Lv-L/PistonLiquidRocket/Documentation Vault/99-Attachments/Nozzle.png

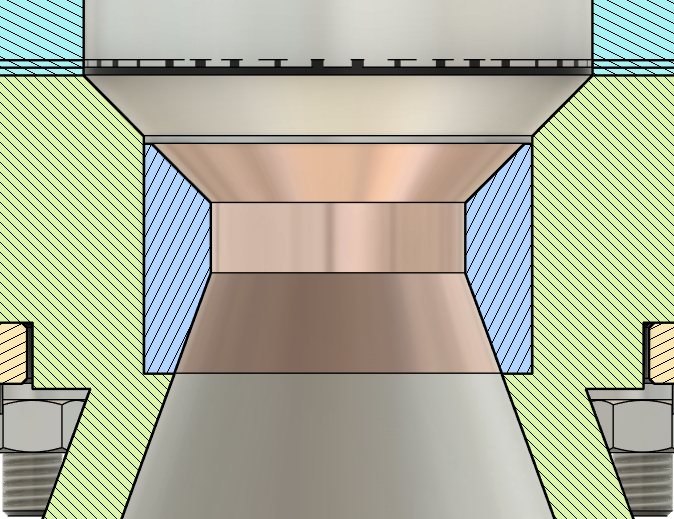
Documentation Vault/99-Attachments/Nozzle.png
