Lv-L/PistonLiquidRocket/Documentation Vault/00-Project/Decisions Log.md

| Date | Decision | Rationale | Alternatives Considered |
| --- | --- | --- | --- |
| 7/06/2026 | IPA fuel type | Higher impulse for same tank volume as ethanol at ~2500 K flame temperature. Hydrocarbons ruled out for ease of reuse (cleanliness) | Ethanol, hydrocarbon fuels |
