Lv-L/PistonLiquidRocket/Documentation Vault/02-Design/01-Propulsion System/01-Propulsion System Overview.md

# Propulsion System Overview

## Propellant Selection
<!-- Oxidizer / fuel choices, reasoning -->

## Performance Targets
| Parameter | Value |
| --- | --- |
| Total impulse | ~5000 Ns, <5120 Ns |
| Liftoff TWR | 5 (minimum) |
| Pressure rating | 1000 psi |
Total impulse: 5000 Ns at lowest (highest impulse) ambient temperature to stay under L2 limit of 5120 Ns [(L motor)](https://en.wikipedia.org/wiki/Model_rocket_motor_classification)
TWR: "at least" 5, from [Tripoli](https://www.tripoli.org/safetycode) - **880 N minimum initial thrust** at an initial mass estimate of 18 kg (from Half Cat, full propellant load)
Pressure rating: 1000 psi for saturation pressure of N2O at 35 deg C
## Fluid System Architecture
Pressure fed by nitrous oxide, as required by [Tripoli](https://tripoli.org/content.aspx?page_id=5&club_id=795696&item_id=126571&)

P&ID Diagram:
![[P&ID.png]]

## Engine Architecture
### Oxidiser
Nitrous oxide (N<sub>2</sub>O) is used as the oxidiser due to its explicit requirement by Tripoli. It self-pressurises at room temperature and has limited chemical incompatibilities (unlike liquid oxygen), and is relatively non-toxic (compared to hydrogen peroxide).
### Fuel
A comparison of potential fuel types is summarised below:

| Fuel Type | Safety | Cost | Availability | Max Isp (s) | Flame | Notes |
| --- | --- | --- | --- | --- | --- | --- |
| Isopropyl alcohol (IPA) | Good | [$4.5/L](https://www.sydneysolvents.com.au/isopropyl-alcohol-100-20-litre) | Delivery | 257 s | Faint orange | Easy to obtain pure |
| Ethanol | Good | [$4.0/L](https://www.sydneysolvents.com.au/industrial-methylated-spirits-20-litre) | Delivery | 260 s | Almost invisible blue/yellow | Sometimes low purity |
| Diesel | Good | [$2.1/L](https://petrolspy.com.au/map/latlng/-27.530393745221538/153.04868461871592) | Any petrol station | 251 s | Bright orange | Leaves oily film |
| E85 | Moderate | [$2.3/L](https://petrolspy.com.au/map/latlng/-27.544466300664432/153.06961875315346) | United petrol station | 258 s | Moderate orange/light blue | More flammable than ethanol |
| Acetone | Moderate | [$4.8/L](https://www.sydneysolvents.com.au/acetone-20-litre) | Delivery | 253 s | Moderate orange/blue | Tends to swell O-rings |
| Methanol | Poor | [$2.5/L](https://www.sydneysolvents.com.au/methanol-20-litre) | Delivery | ~ | Almost invisible light blue  | "Should not be used" - Half Cat |
On the basis of safety, the use of methanol was ruled out due to its high toxicity.

For propellants, ethanol was chosen for its high performance and availability, with E85 as a secondary option for a more visible flame at the slight cost of performance. Running the engine with ethanol will require less maintenance as it doesn't leave a residue, unlike E85.

![[tc_isp_vs_lambda.png]]

An OF of 2 will be used initially to reduce flame temperature with a small penalty in Isp. For ethanol, an OF ratio of 2 results in an adiabatic flame temperature of 2828 K and an Isp of 252 s. This means a penalty of 8 s of Isp gives a temperature reduction of 489 K (with ethanol's peak Isp being 260 s at an adiabatic flame temperature of 3317 K).

### Nozzle
The nozzle throat diameter and expansion ratio were copied taken Half Cat:

| Variable | Value |
| --- | ----- |
| Throat diameter (mm) | 25 |
| Expansion Ratio | 4 |

### Combustion Chamber
Chamber dimensions were copied from Half Cat, given that chamber sizing is typically done from past experience.

| **Dimension name** | Dimension (mm) |
| --- | --- |
| Chamber ID | 51 |
| Chamber length | 127 |
| Characteristic length (L*) | 635 |
### Components
#### Tanks
The tank is a "piston style" tank that is the same as Half Cat's design, where the vapor pressure of the N2O pushes along a piston to expel the fuel. From the Half Cat Mojave Sphinx Guidebook:
![[MS Propellant Tank.png]]
#### Regulators
No regulators are used - instead the main valves are set to open at a point between the operating pressure and the burst pressure of the tank, in the case of an extremely hot day or radiative heating of the tank resulting in it being heated to greater than 35 degrees C.
#### Valves
1/4" (8mm) BSP, 304 Stainless Steel, 2 Pc Ball Valve, Full Port, 1000 PSI - [Camlock Fittings]([https://www.aircraftspruce.com.au/catalog/appages/highpressurevalve.php](https://www.camlockfittings.com.au/1-4-ball-valve-ss304.html))
Use 3d print with [DS3225 servo - Amazon](https://www.amazon.com.au/AKLOSIPY-DS3225MG-Digital-Servo-Multiple/dp/B0FX16CGW4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) to convert to servo valve for ox fill valve, main ox valve and main fuel valve.
#### Plumbing (Hose + Fittings)
See [03-Fluid System](03-Fluid%20System.md)
## Analysis
The simulation models a piston-fed N2O + liquid fuel rocket where a two-phase N2O tank self-pressurises and drives a piston to expel fuel. At each timestep it computes propellant mass flow rates through injector orifices (using incompressible orifice flow), calls rocketCEA to get ideal combustion properties (T0, γ, MW, c*), applies combustion efficiency to get actual c*, then solves the chamber pressure from c* = Pc·At/ṁ. Thrust and Isp follow from the nozzle expansion, and the N2O tank state evolves via an adiabatic energy balance accounting for liquid/vapour phase change.

For the purposes of initial analysis, a target injector pressure drop was set at 20% initial feed pressure. A combustion efficiency of 65% and a nozzle efficiency of 97% was used. Half Cat's feed line geometries were used to estimate feed line pressure drop, this can be fine tuned as the design progresses to CAD.

Inputs (non exhaustive):
- Tank volume (ox + fuel): 5L
- Ox tank diameter: 101.6 mm
- Ox ullage: 5% by volume
- Fuel: Ethanol
- O/F: 2.0
- Throat diameter: 25.4 mm
- Nozzle expansion ratio: 4

Hot day (30C):
![[engine_simulation_30C.png]]
Results:
- Burn time: 2.7 s
- Avg/peak thrust: 1473.0 N / 1735.5 N
- Avg Isp: 141.9 s
- Total impulse: 4006.5 Ns

Cold day (10C):
![[engine_simulation_10C.png]]
Results:
- Burn time: 4.29 s
- Avg/peak thrust: 1143.9 N / 1351.7 N
- Avg Isp: 137.6 s
- Total impulse: 4894.2 Ns
## Related
- [[02-Design/03-Ground Support Equipment/GSE Overview]]
- [[02-Design/04-Flight Systems/Flight Systems Overview]]
