Lv-L/PistonLiquidRocket/Documentation Vault/02-Design/01-Propulsion System/03-Fluid System.md

# Oxidiser
# QD - Ox Tank
| Fitting | Input | Output | Material | Cost | Supplier |
| --- | --- | --- | --- | ---- | --- |
| QD fitting (female) | - | 1/8" BSPT female | | | |
| Air line elbow | 1/8" BSPT male | 1/4" OD tube compression (Uni-Lok) | Brass | | [IFS B-04UME-02R](https://www.ifsqld.com.au/libraries/resources/pdfs/IFS%202025%20UN-PRICED%20MASTER%20PT2.pdf) |

# Ox Tank - Combustion Chamber
| Fitting | Input | Output | Material | Cost | Supplier |
| --- | --- | --- | --- | --- | --- |
| Bulkhead | - | 1/4" BSPT female | Aluminium | - | - |
| Nipple | 1/4" BSPT male | 1/4" BSPT male | Brass | | [IFS 2812](https://www.ifsqld.com.au/libraries/resources/pdfs/IFS%202025%20UN-PRICED%20MASTER%20PT1.pdf)  |
| Main valve | 1/4" BSPP female | 1/4" BSPP female | 304 stainless steel | A$6.29 | [Camlock Fittings](https://www.camlockfittings.com.au/1-4-ball-valve-ss304.html) |
| Flare fitting | 1/4" BSPT male | AN6 male | Aluminium | A$3.99 | [EFI Solutions](https://www.efisolutions.com.au/bspt-1-4-to-male-an6) |
| 180° hose end | AN6 female | AN6 hose | Aluminium | A$18.39 | [EFI Solutions](https://www.efisolutions.com.au/180-degree-full-flow-ptfe-teflon-hose-end-an6) |
| Line (7/16" OD) | AN6 hose | AN6 hose | PTFE, braided stainless | A$18.99/m | [EFI Solutions](https://www.efisolutions.com.au/200-series-ptfe-teflon-braided-stainless-steel-hos~50095) |
| Hose end | AN6 hose | AN6 female | Aluminium | A$8.99 | [EFI Solutions](https://www.efisolutions.com.au/straight-full-flow-ptfe-teflon-hose-end-an6-black) |
| Flare fitting | AN6 male | 1/4" BSPT male | Aluminium | A$3.99 | [EFI Solutions](https://www.efisolutions.com.au/bspt-1-4-to-male-an6) |
| Injector | 1/4" BSPT female | - | Aluminium | - | - |

# Fuel

## Fuel Tank - Combustion Chamber
| Fitting | Input | Output | Material | Cost | Supplier |
| --- | --- | --- | --- | --- | --- |
| Bulkhead | - | 1/4" BSPT female | Aluminium | - | - |
| Nipple | 1/4" BSPT male | 1/4" BSPT male | Brass | | [IFS 2812](https://www.ifsqld.com.au/libraries/resources/pdfs/IFS%202025%20UN-PRICED%20MASTER%20PT1.pdf)  |
| Main valve | 1/4" BSPP female | 1/4" BSPP female | 304 stainless steel | A$6.29 | [Camlock Fittings](https://www.camlockfittings.com.au/1-4-ball-valve-ss304.html) |
| Flare fitting | 1/4" BSPT male | AN6 male | Aluminium | A$3.99 | [EFI Solutions](https://www.efisolutions.com.au/bspt-1-4-to-male-an6) |
| Hose end | AN6 female | AN6 hose | Aluminium | A$8.99 | [EFI Solutions](https://www.efisolutions.com.au/straight-full-flow-ptfe-teflon-hose-end-an6-black) |
| Line (7/16" OD) | AN6 hose | AN6 hose | PTFE, braided stainless | A$18.99/m | [EFI Solutions](https://www.efisolutions.com.au/200-series-ptfe-teflon-braided-stainless-steel-hos~50095) |
| Hose end | AN6 hose | AN6 female | Aluminium | A$8.99 | [EFI Solutions](https://www.efisolutions.com.au/straight-full-flow-ptfe-teflon-hose-end-an6-black) |
| Flare fitting | AN6 male | 1/8" BSPT male | Aluminium | A$3.99 | [EFI Solutions](https://www.efisolutions.com.au/bspt-1-8-to-male-an6) |
| Injector | 1/8" BSPT female | - | Aluminium | - | - |
