Lv-L/PistonLiquidRocket/Documentation Vault/02-Design/03-Flight Systems/01-Flight Systems Overview.md

# Flight Systems Overview

## Airframe
The airframe tubes and nosecone are made of fibreglass. For the tubes, an inner diameter of 101.6 mm is used, allowing for 4 inch aluminium tube stock to be used as a mandrel.

## Structures
<!-- Engine mount, tank mounts, load paths -->

## Recovery
<!-- Dual deploy system, ejection charges, parachutes -->

## Avionics
<!-- Flight computer, altimeter, wiring -->

## Analysis
<!-- Mass budget, CG/CP, stability margin -->

## Related
- [[01-Propulsion System Overview]]
- [[01-Requirements/Requirements]]
