Lv-L/PistonLiquidRocket/Documentation Vault/02-Design/03-Flight Systems/02-Fins.md

The fins are made of four 1/4" thick plywood pieces cut into a swept profile, ending just after the nozzle. They are mounted to four 25x25x3 mm aluminium brackets, which also serve to connect the thrust chamber to the propellant tank.
