Lv-L/PistonLiquidRocket/Documentation Vault/02-Design/02-Ground Support Equipment/01-GSE Overview.md

# Ground Support Equipment Overview

## Fill & Drain System
<!-- Propellant loading, venting, drain procedures -->

## Pressurization Panel
<!-- Regulators, gauges, fill lines -->

## Ignition System
<!-- Igniter driver, arming logic, safing -->

## Test Stand
<!-- Thrust measurement, instrumentation, hold-down -->

## Related
- [[01-Propulsion System Overview]]
- [[03-Testing/Testing Index]]
