Lv-L/PistonLiquidRocket/Documentation Vault/05-Reference/Reference Index.md

# Reference Index

## Standards
- [Tripoli Bi-Propellant Liquid Motor Requirements](https://tripoli.org/content.aspx?page_id=5&club_id=795696&item_id=126571&)

## Datasheets

## Literature / Papers
