Lv-L/PistonLiquidRocket/Documentation Vault/00-Project/MOC.md

# Project Map of Content

## Folders
- [[01-Requirements]] — system requirements and constraints
- [[02-Design]] — propulsion system, propellant system, GSE, flight systems
- [[03-Testing]] — test plans, data, anomaly reports
- [[04-Procurement]] — suppliers, lead times, specs
- [[05-Reference]] — standards, datasheets, literature

## Key Documents
- [[01-Requirements/Requirements]] — top-level requirements
- [[00-Project/Timeline]] — project milestones
- [[01-Propulsion System Overview]]
- [[01-GSE Overview]]
- [[01-Flight Systems Overview]]
