Lv-L/PistonLiquidRocket/bolt_tearout.png

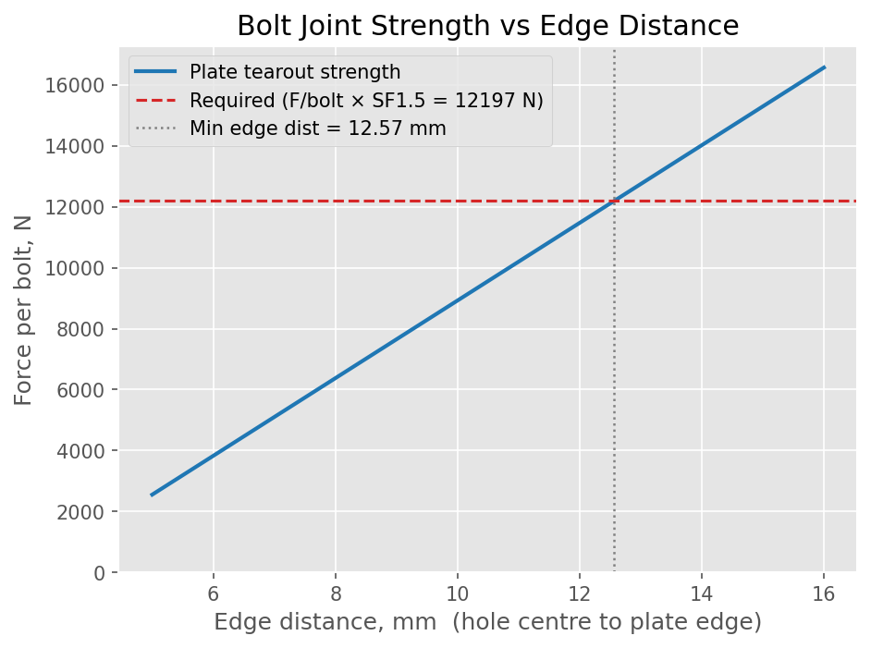
bolt_tearout.png
