Lv-L/PistonLiquidRocket/Documentation Vault/99-Attachments/bolt_tearout.png

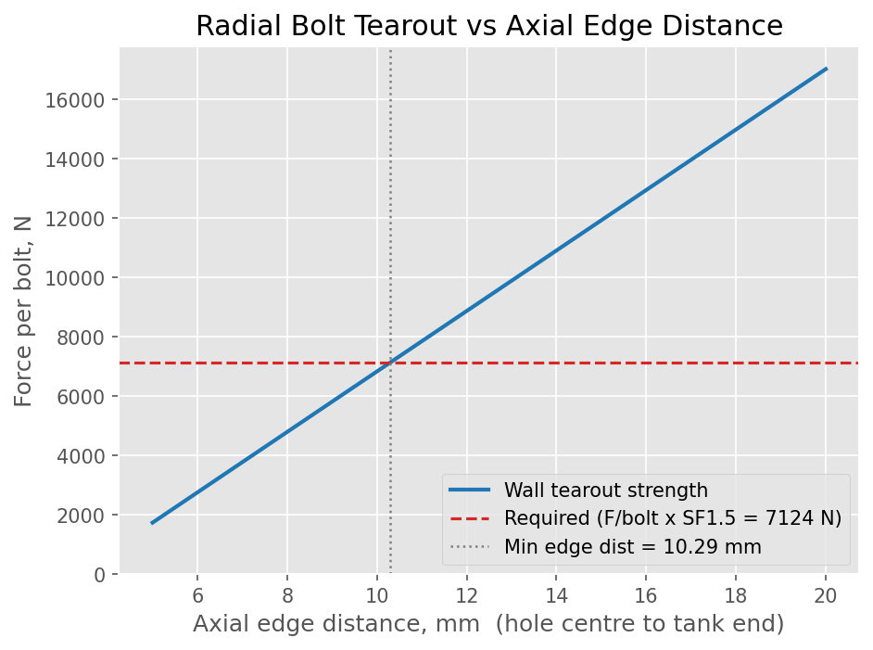
Documentation Vault/99-Attachments/bolt_tearout.png
