Lv-L/PistonLiquidRocket/Documentation Vault/99-Attachments/engine_simulation.png

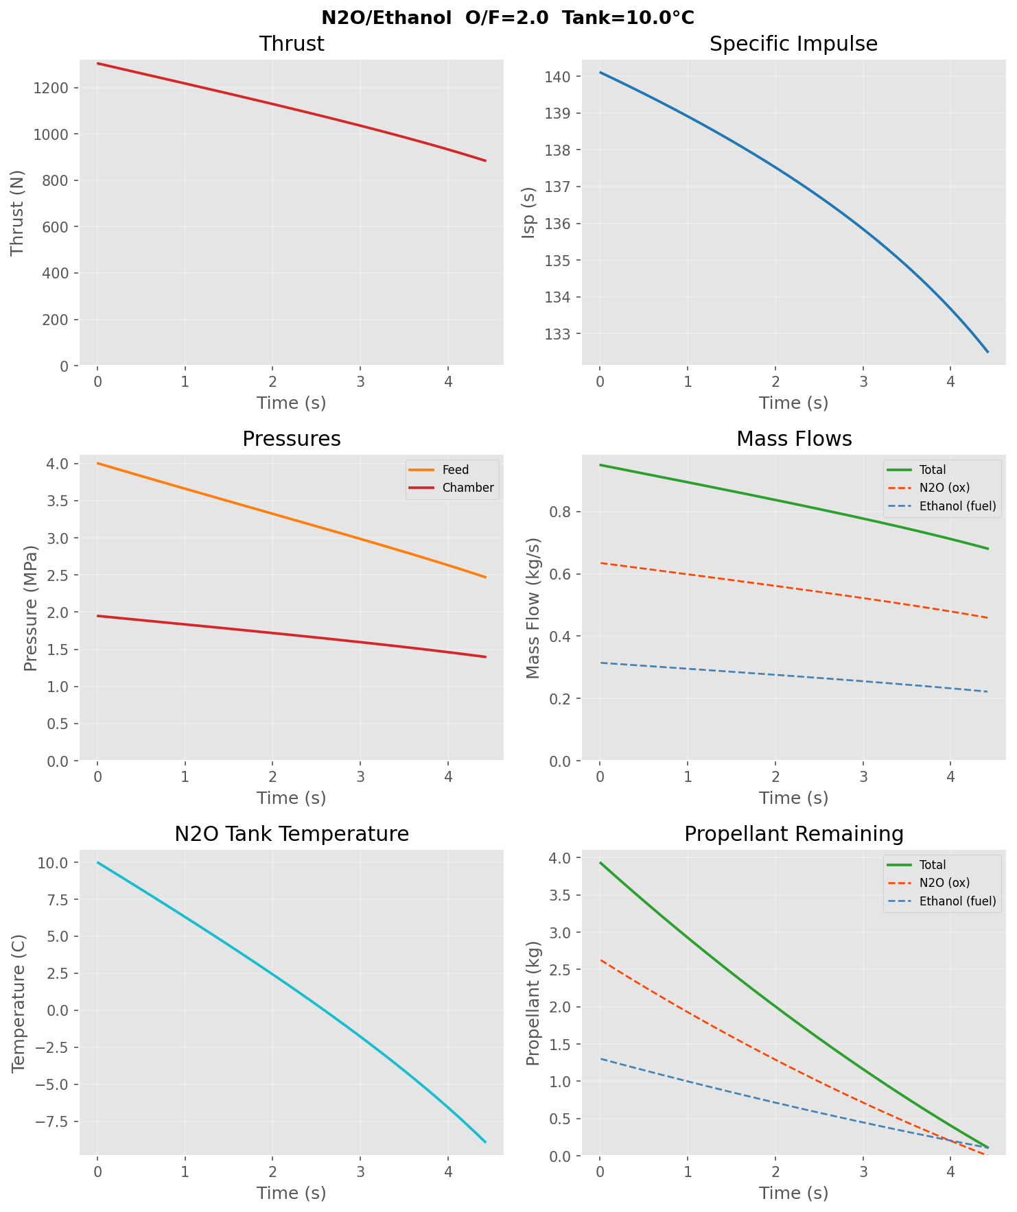
Documentation Vault/99-Attachments/engine_simulation.png
