Lv-L/PistonLiquidRocket/Documentation Vault/99-Attachments/O-ring Bulkhead.png

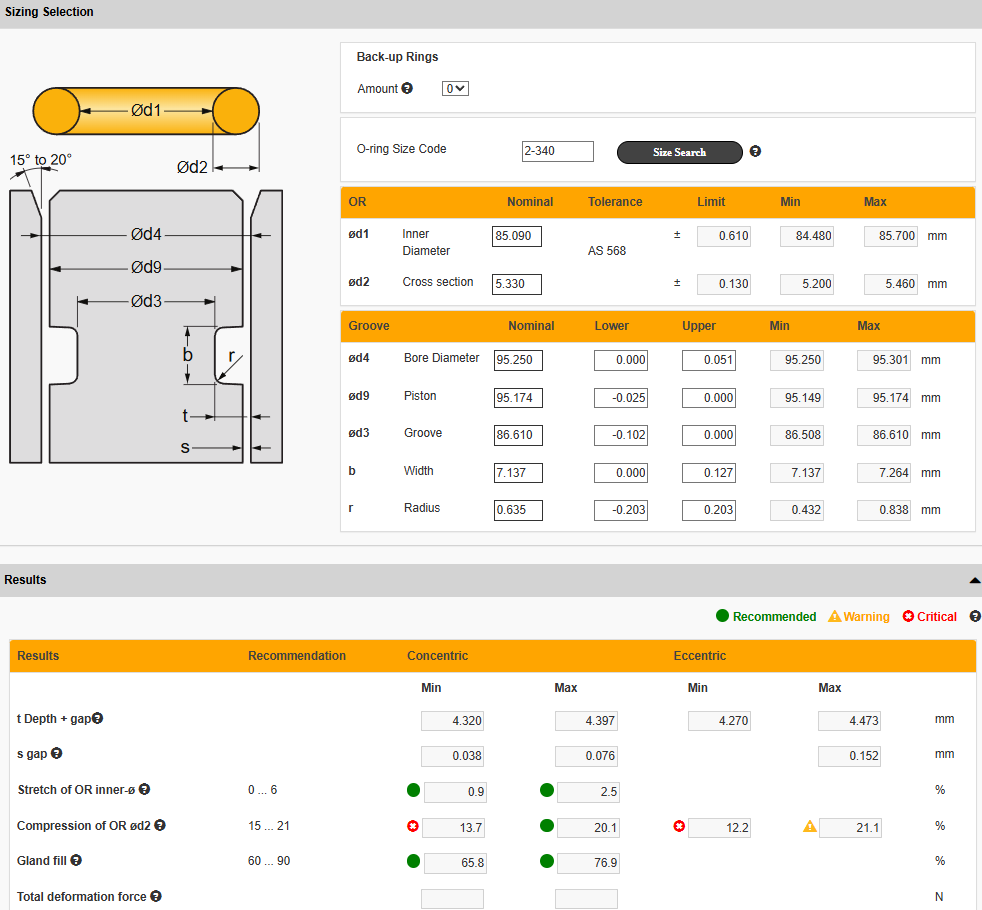
Documentation Vault/99-Attachments/O-ring Bulkhead.png
