Lv-L/PistonLiquidRocket/Documentation Vault/99-Attachments/O-ring Bulkheads.png

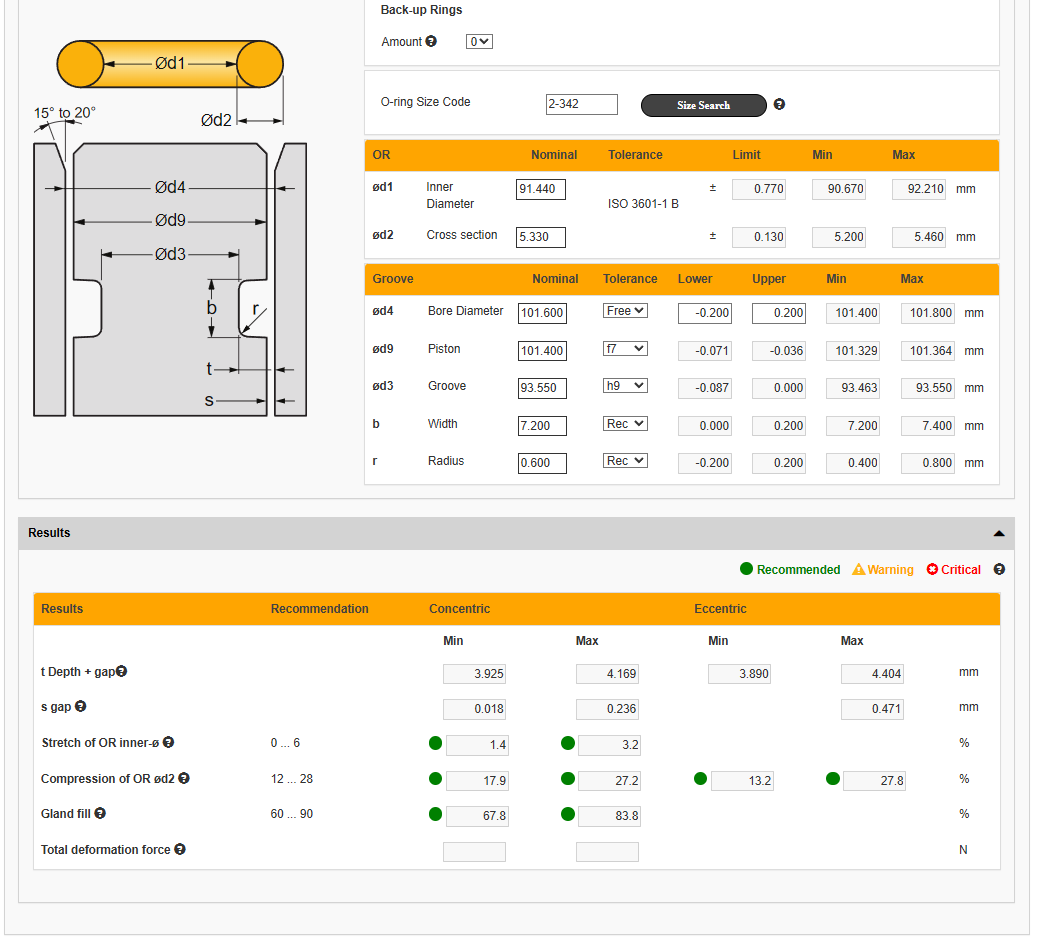
Documentation Vault/99-Attachments/O-ring Bulkheads.png
