Lv-L/PistonLiquidRocket/Documentation Vault/99-Attachments/O-ring Extrusion.png

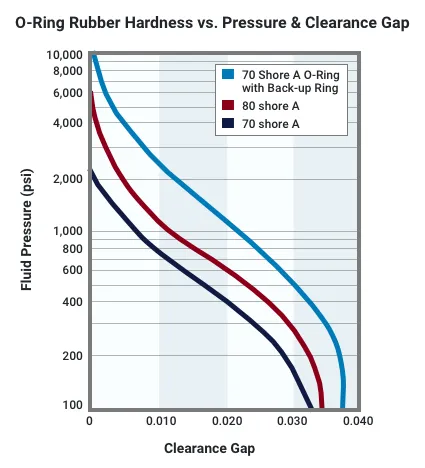
Documentation Vault/99-Attachments/O-ring Extrusion.png
