Lv-L/PistonLiquidRocket/Documentation Vault/99-Attachments/O-ring Injector.png

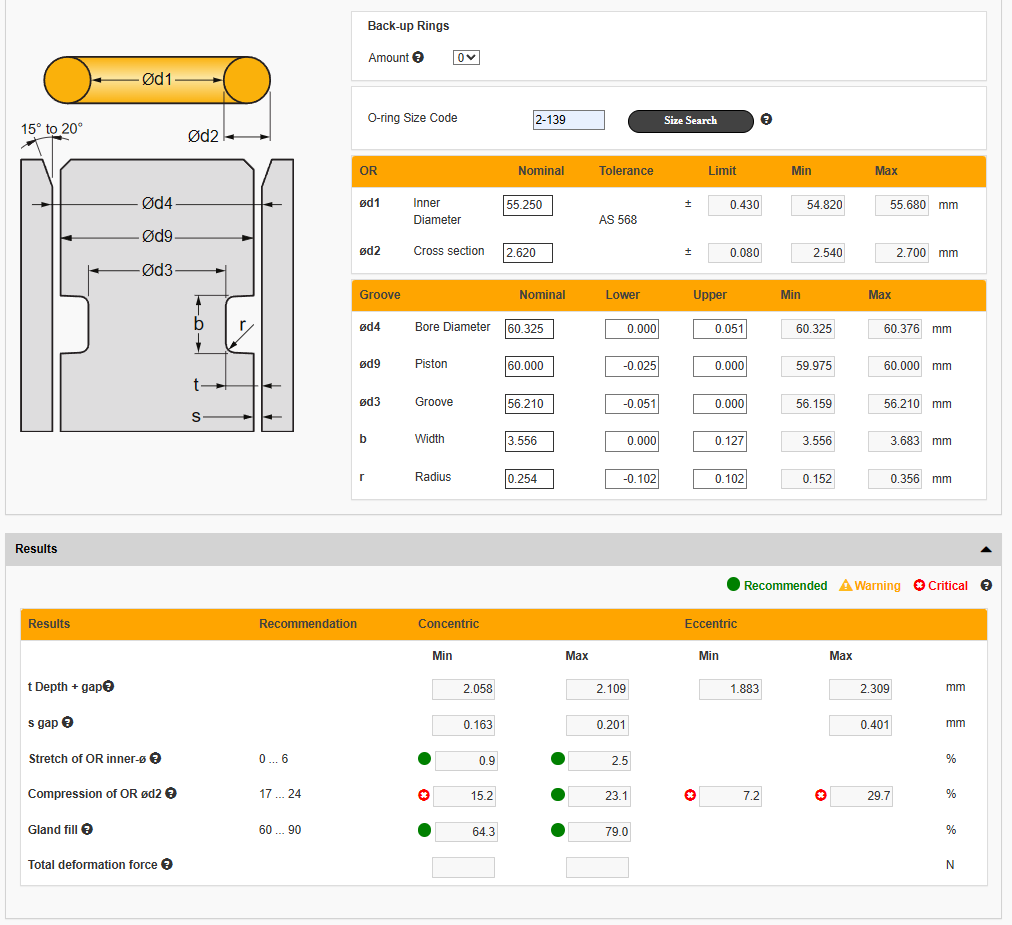
Documentation Vault/99-Attachments/O-ring Injector.png
