Lv-L/PistonLiquidRocket/Documentation Vault/99-Attachments/O-ring Piston.png

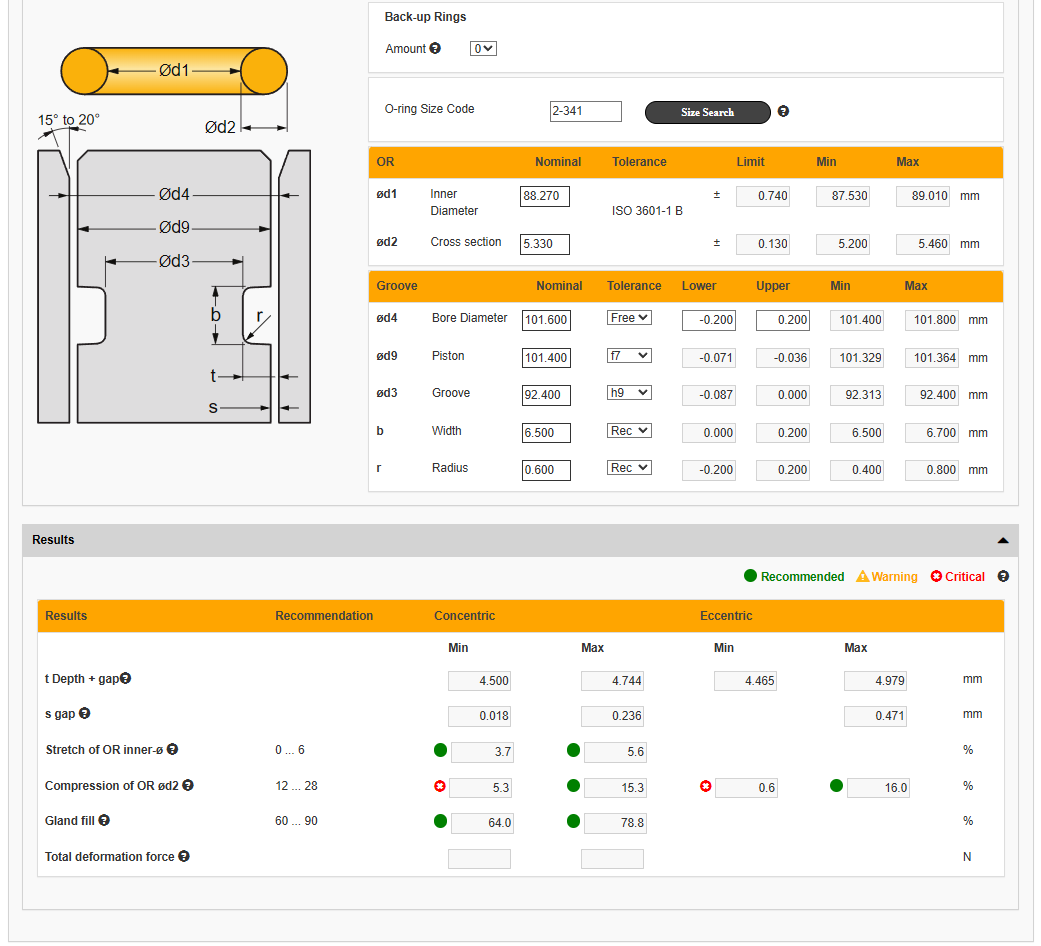
Documentation Vault/99-Attachments/O-ring Piston.png
