Lv-L/PistonLiquidRocket/Documentation Vault/99-Attachments/tc_isp_vs_lambda.png

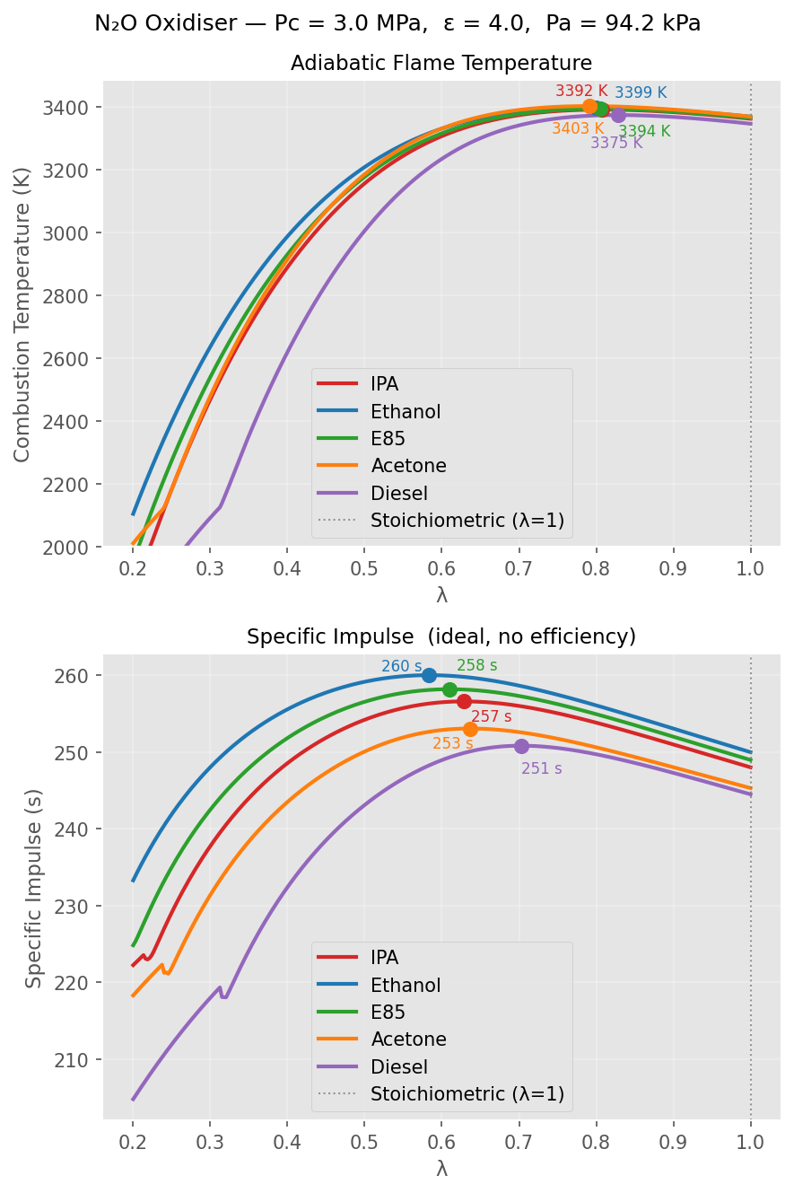
Documentation Vault/99-Attachments/tc_isp_vs_lambda.png
