Lv-L/PistonLiquidRocket/Documentation Vault/P&ID.png

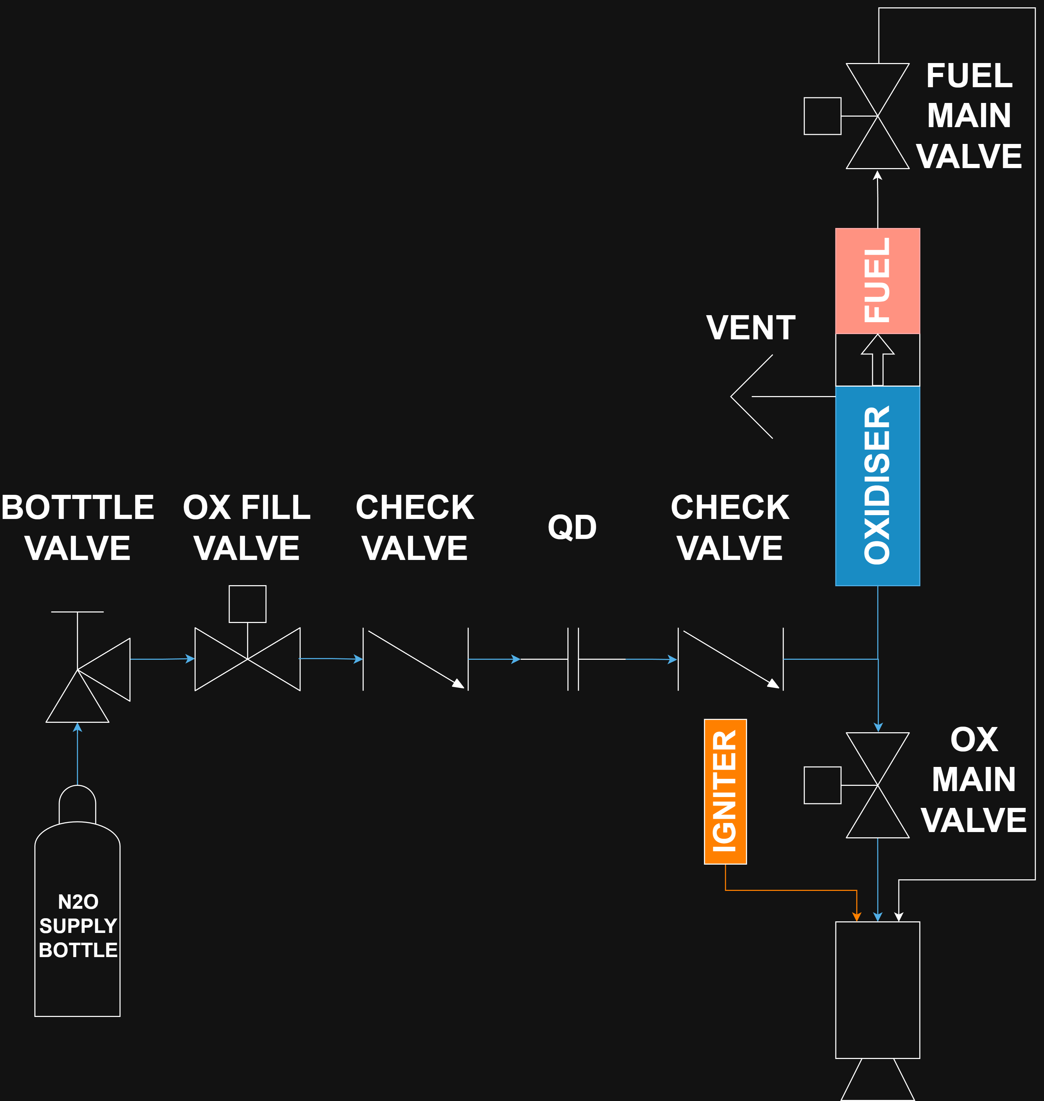
Documentation Vault/P&ID.png
