Lv-L/PistonLiquidRocket/Documentation Vault/Pasted image 20260610212356.png

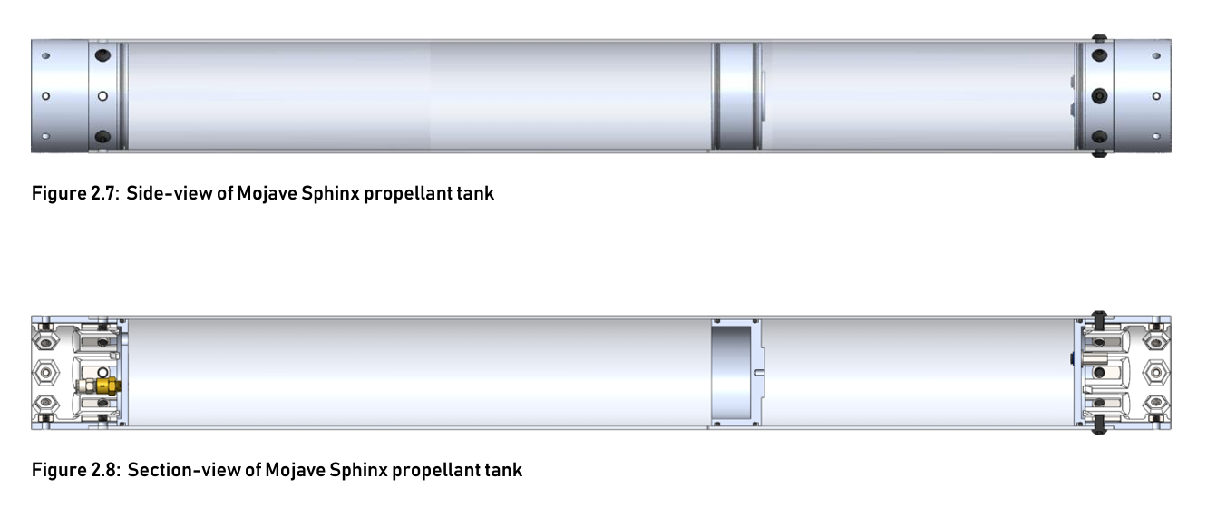
Documentation Vault/Pasted image 20260610212356.png
