Lv-L/PistonLiquidRocket/Hoop Stress.png

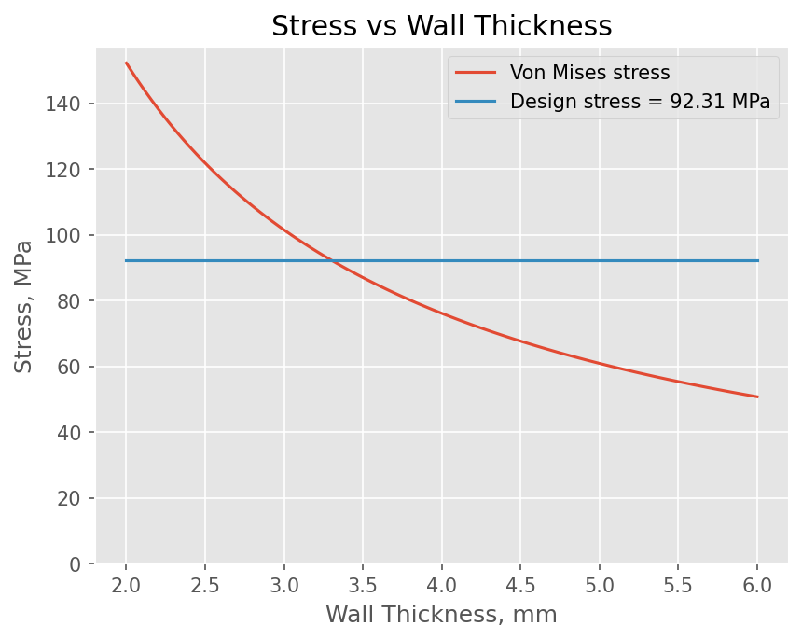
Hoop Stress.png
