Lv-L/PistonLiquidRocket/Simulation/lambda_vs_of.png

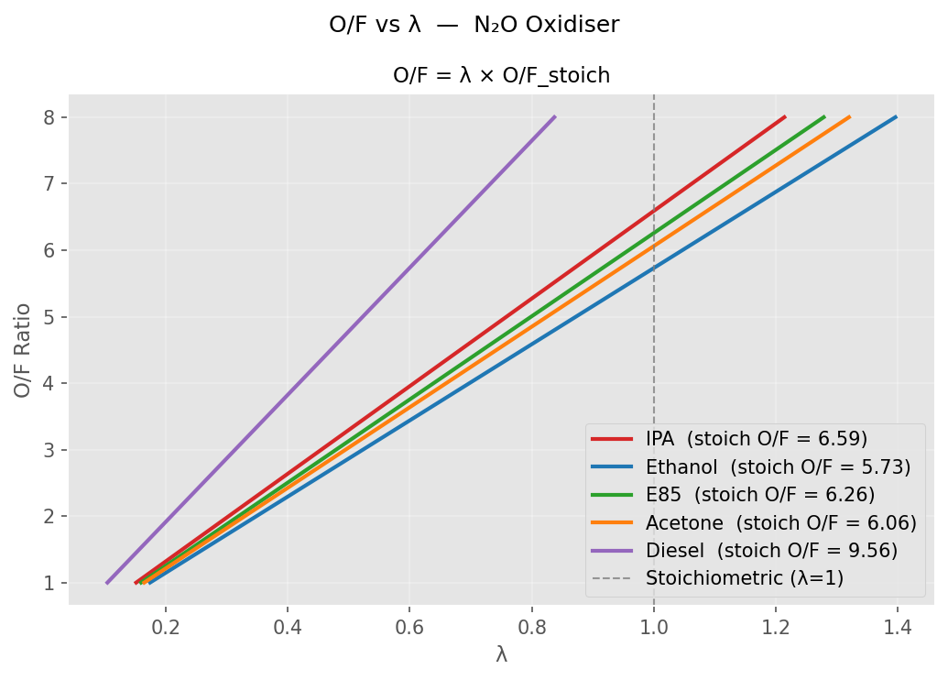
Simulation/lambda_vs_of.png
