Lv-L/PistonLiquidRocket/Finance/Purchases.xlsx

Description | Buyer | Cost | Date | Receipt name | Receipt
5x valves | Luke | $52.20 | 2026-11-01 | 20261101 - 5x valves.pdf | Open File
