Lv-L/PistonLiquidRocket/(list of files, cad)

Other CAD files:
CAD/DL_servo_mount.f3z
