Lv-L/PistonLiquidRocket/Documentation Vault/03-Testing/Testing Index.md

# Testing Index

## Test Plans
- Cold-flow test plan
- Hot-fire test plan

## Test Data

## Anomaly Reports
