Lv-L/PistonLiquidRocket/(commit log)

2026-05-30 Refactor injector system: orifice equations replace fixed dP/P
    Replace simplified injector_dp_frac with physics-based orifice equation
    for each propellant:
    - ṁ = Cd × A × √(2ρ(P_feed - Pc))
    - Cd and A now configurable separately (default Cd=0.65 each)
    - A values auto-sized from design O/F and target dP/P fraction
    Chamber pressure now solved from injector + nozzle constraint:
    - ṁ_ox + ṁ_fuel = k_mdot × Pc (nozzle choked throat)
    - Uses Newton-Raphson solver in each timestep
    - O/F is live output (mdot_ox / mdot_fuel) not fixed input
    Key improvements:
    - Geometry-based design (injector areas now explicit)
    - O/F can vary dynamically as feed pressures change
    - Clean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
2026-06-11 Tank burst pressure
2026-06-11 Bolt tear-out
2026-06-17 Structural updates
    10 M6s -> 8 M8s for tank bolts
